Lironktf/Bluer/Arduino/MPU Connections Schematic Altium.JPG

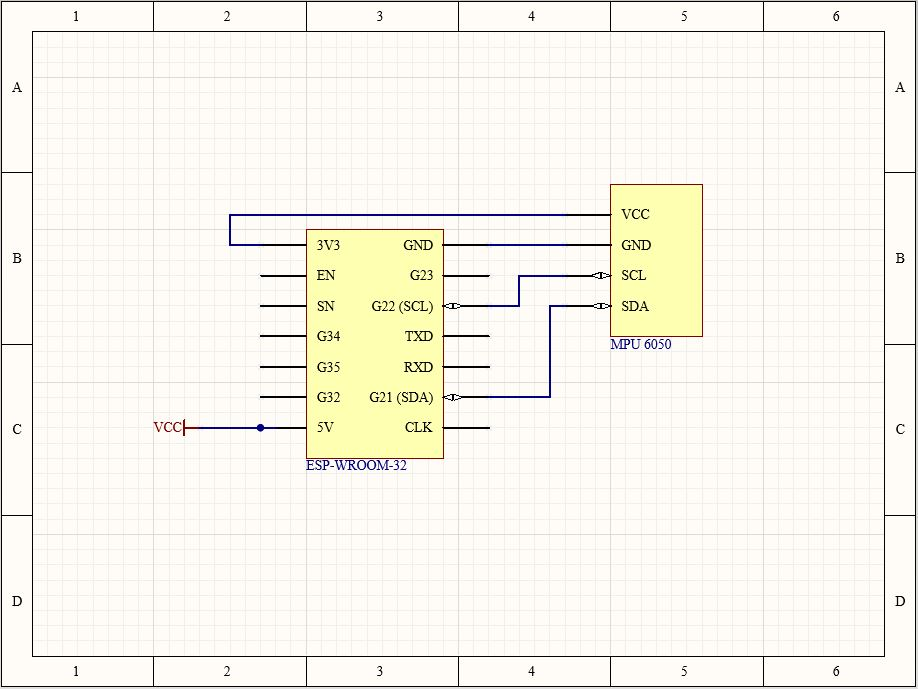
Arduino/MPU Connections Schematic Altium.JPG
