Lironktf/Bluer/onlineExmp/Ressources/ESP32_D1_Mini.stl

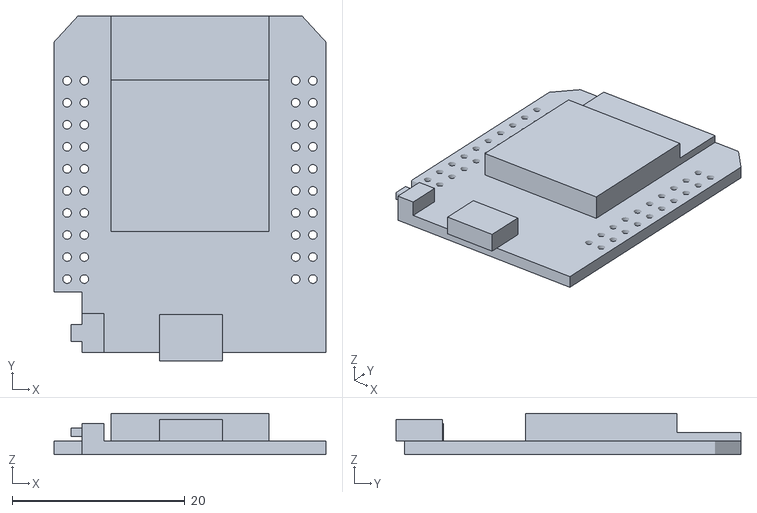
[picture p2: CAD file, 2026-01-26]
onlineExmp/Ressources/ESP32_D1_Mini.stl
31.5 x 40.0 x 4.80
