Lironktf/Bluer/(list of files, cad)

Other CAD files:
onlineExmp/Case/BLE-Scanner.scad
