Lironktf/Bluer/Arduino/tools/snapshot_recording.py

#!/usr/bin/env python3
"""Turns a recording CSV from /test/live into snapshot graphs of only the moments that matter.

On /test/live choose the pair, press Start recording, run your tests, then Download CSV
(a recording lasts a day at most, and the website deletes it 3 days after it ends). Then:

    pip3 install matplotlib
    python3 snapshot_recording.py sj-4_2026-11-04-14-03.csv
    python3 snapshot_recording.py day1.csv day2.csv --out my_test

Quiet stretches are skipped. Everything else becomes a PNG:
  washer  ~20 s around every burst of water over 20,000 (first fill, refills, a neighbour) or door
          drop over 700,000. Both sit below the node's thresholds on purpose, so near misses show.
          The last water-in before the washer stops running says when it stopped. Of a run of
          neighbour-only bursts (water while idle, no door), only the loudest is saved.
  dryer   a cycle is avg10 above the node's dryer-on threshold at that moment. Dips under it stay
          in the same cycle unless avg10 falls below 1.5 for over a minute. The first 2 min and the
          end are shown; the start snapshot gives the cycle's lowest avg10 and how often it dipped.
          Door jumps above the node's door threshold count only outside a cycle, since a running
          drum shakes the door too.
A dryer door bump and a washer door bump close together are tagged as possibly the same bump,
felt by both sensors of the pair. Graphs draw the thresholds the node had at that moment.
Times are in this computer's local time, to match your notes. Reads files only: it never
talks to a node or the website.
"""
import argparse
import bisect
import csv
import sys
from collections import namedtuple
from datetime import datetime, timedelta
from pathlib import Path

import matplotlib

matplotlib.use("Agg")  # files only, no window
import matplotlib.dates as mdates
import matplotlib.pyplot as plt

# Quiet cutoffs: a stretch below all four is never graphed.
WASHER_WATER = 20_000  # a washer's own running background and faint neighbours sit around 10,000-20,000
WASHER_DOOR = 700_000
# The dryer uses the node's own thresholds; these apply only to a CSV downloaded before they were included.
DRYER_ON = 2.2
DRYER_DOOR = 2.0

PERIOD = timedelta(seconds=5)  # each reading is the highest value of the 5 s ending at its time
MIN_SNAPSHOT = timedelta(seconds=20)
WASHER_PAD = timedelta(seconds=10)
WASHER_GAP = timedelta(seconds=15)  # bursts closer than this are one snapshot
START_BEFORE = timedelta(seconds=30)  # shown before a first fill
IDLE_SPAN = timedelta(minutes=1)  # a long neighbour stretch is shown as this much either side of its loudest reading
CYCLE_GAP = timedelta(seconds=60)  # any dip shorter than this stays inside the cycle
DIP_FLOOR = 1.5  # a longer dip stays inside it too, as long as avg10 never falls below this...
DIP_MAX = timedelta(minutes=10)  # ...for no longer than this
CYCLE_BEFORE = timedelta(seconds=30)
CYCLE_START = timedelta(minutes=2)
CYCLE_END = timedelta(minutes=2)
CYCLE_AFTER = timedelta(seconds=60)
DOOR_PAD = timedelta(seconds=20)
# A washer door bump this close to a dryer door bump may be the same one; the washer's readings
# reach the website up to ~15 s behind the dryer's.
MATCH_BEFORE = timedelta(seconds=20)
MATCH_AFTER = timedelta(seconds=35)
MATCH_NOTE = "could be activity from matching node"
SHORT_CYCLE = "cycle (possible just door opened triggering a cycle)"
IDLE_WATER = "water while idle (neighbour?)"
IDLE_RUN_GAP = timedelta(minutes=10)  # neighbour bursts closer than this count as one run

THRESHOLDS = ["dryer_on", "dryer_door", "first_fill", "refill", "refill_bands", "washer_door"]
BAND_NAMES = {1: "lower band", 2: "either band", 3: "upper band"}

Dryer = namedtuple("Dryer", "t avg10 door running empty")
Washer = namedtuple("Washer", "t w1 w2 drop running empty")
Window = namedtuple("Window", "start end label event note", defaults=("",))  # event: the first reading that caused it


def load(paths):
    dryer, washer, changes = {}, {}, {}
    for path in paths:
        with open(path, newline="", encoding="utf-8") as f:
            for row in csv.DictReader(f):
                t = datetime.fromisoformat(row["time"].replace("Z", "+00:00")).astimezone()
                # Thresholds are written on the first row and wherever they change.
                if all(row.get(k) for k in THRESHOLDS):
                    changes[t] = {k: float(row[k]) for k in THRESHOLDS}
                if row["machine"] == "dryer":
                    dryer[t] = Dryer(t, float(row["avg10"]), float(row["door_jump"]),
                                     int(row["running"]), int(row["empty"]))
                elif row["machine"] == "washer":
                    washer[t] = Washer(t, float(row["water1"]), float(row["water2"]), float(row["door_drop"]),
                                       int(row["running"]), int(row["empty"]))
    # Keyed by time, so files that overlap at their boundary don't double a reading.
    return [dryer[t] for t in sorted(dryer)], [washer[t] for t in sorted(washer)], sorted(changes.items())


class Thresholds:
    def __init__(self, changes):
        self.times = [t for t, _ in changes]
        self.values = [v for _, v in changes]

    def at(self, t):
        """The thresholds in force at t; {} for a CSV downloaded before they were included."""
        if not self.values:
            return {}
        return self.values[max(bisect.bisect_right(self.times, t) - 1, 0)]


def group(times, gap):
    """Consecutive times no more than gap apart, as [first, last] pairs."""
    groups = []
    for t in times:
        if groups and t - groups[-1][1] <= gap:
            groups[-1][1] = t
        else:
            groups.append([t, t])
    return groups


def widen(start, end):
    short = MIN_SNAPSHOT - (end - start)
    return (start - short / 2, end + short / 2) if short > timedelta(0) else (start, end)


def merge(windows):
    merged = []
    for w in sorted(windows, key=lambda w: w.start):
        if merged and w.start <= merged[-1].end:
            last = merged.pop()
            if not w.label or w.label in last.label.split(" + "):
                label = last.label
            else:
                label = f"{last.label} + {w.label}" if last.label else w.label
            note = "\n".join(n for n in (last.note, w.note) if n)
            merged.append(Window(last.start, max(last.end, w.end), label, min(last.event, w.event), note))
        else:
            merged.append(w)
    return merged


def rows_in(rows, w):
    return [r for r in rows if w.start <= r.t <= w.end + PERIOD]


def first_time(rows, hit, default):
    return next((r.t for r in rows if hit(r)), default)


def duration(td):
    seconds = max(int(td.total_seconds()), 0)
    return f"{seconds // 60} min {seconds % 60} s" if seconds >= 60 else f"{seconds} s"


def day(t):
    """4 Nov -> "4th Nov"."""
    suffix = "th" if 11 <= t.day % 100 <= 13 else {1: "st", 2: "nd", 3: "rd"}.get(t.day % 10, "th")
    return f"{t.day}{suffix} {t:%b}"


def washer_label(rows):
    labels = []
    if any(r.drop >= WASHER_DOOR for r in rows):
        labels.append("door")
    wet = [i for i, r in enumerate(rows) if max(r.w1, r.w2) >= WASHER_WATER]
    if wet:
        before = rows[wet[0] - 1].running if wet[0] > 0 else rows[0].running
        if not before and any(r.running for r in rows[wet[0]:]):
            labels.append("first fill")
        elif before:
            labels.append("water while running")
        else:
            labels.append("water while idle (neighbour?)")
    return " + ".join(labels)


def washer_windows(washer):
    # Water bursts are chained, but never across a start: a neighbour's water can sit above the
    # cutoff for half an hour and would otherwise glue itself to this washer's first fill.
    groups = []  # (rows, starts_cycle)
    for prev, r in zip([None] + washer[:-1], washer):
        if max(r.w1, r.w2) < WASHER_WATER:
            continue
        starts = prev is not None and not prev.running and r.running
        if groups and not starts and r.t - groups[-1][0][-1].t <= WASHER_GAP:
            groups[-1][0].append(r)
        else:
            groups.append(([r], starts))

    windows = []
    for rows, starts in groups:
        first, last = rows[0].t, rows[-1].t
        start, end = first - PERIOD - (START_BEFORE if starts else WASHER_PAD), last + WASHER_PAD
        if not any(r.running for r in rows) and last - first > 2 * IDLE_SPAN:
            first = max(rows, key=lambda r: max(r.w1, r.w2)).t
            start, end = first - IDLE_SPAN, first + IDLE_SPAN
        start, end = widen(start, end)
        windows.append(Window(start, end, "", first))

    doors = [r.t for r in washer if r.drop >= WASHER_DOOR]
    for first, last in group(doors, PERIOD * 2):
        start, end = widen(first - PERIOD - DOOR_PAD, last + DOOR_PAD)
        windows.append(Window(start, end, "", first))
    return [w._replace(label=washer_label(rows_in(washer, w))) for w in merge(windows)]


def refill_hit(r, th):
    if "refill" not in th:
        return max(r.w1, r.w2) >= WASHER_WATER
    bands = int(th["refill_bands"])
    return ((bands in (1, 2) and r.w1 > th["refill"])
            or (bands in (2, 3) and r.w2 > th["refill"]))


def end_notes(washer, windows, thresholds):
    """For each time the washer stopped running: a note on that cycle's last snapshot where the water
    was above the refill threshold the washer was following, i.e. the last water-in that reset its timer."""
    windows = list(windows)
    wet = [i for i, w in enumerate(windows) if "water" in w.label or "first fill" in w.label]
    previous_end = None
    for prev, r in zip(washer, washer[1:]):
        if not prev.running or r.running:
            continue
        in_cycle = [i for i in wet if windows[i].event < r.t and (previous_end is None or windows[i].event > previous_end)]
        previous_end = r.t
        for i in reversed(in_cycle):
            rows = rows_in(washer, windows[i])
            above = [k for k, row in enumerate(rows) if refill_hit(row, thresholds.at(row.t))]
            if not above:
                continue
            k = above[-1]
            th = thresholds.at(rows[k].t)
            # Without thresholds in the CSV, refill_hit falls back to the quiet cutoff.
            level = f"refill threshold ({th['refill']:,.0f})" if "refill" in th else f"quiet cutoff ({WASHER_WATER:,})"
            dipped = rows[k + 1].t if k + 1 < len(rows) else rows[k].t + PERIOD
            # Readings missing just before the end (Wi-Fi was down) mean it ended somewhere in the gap.
            ended = (f"between {prev.t:%H:%M:%S} and {r.t:%H:%M:%S} (readings missing)"
                     if r.t - prev.t > 3 * PERIOD else f"at {r.t:%H:%M:%S}")
            windows[i] = windows[i]._replace(note=(
                f"This is last water in, washer ended {ended} (running went false), "
                f"{duration(r.t - dipped)} after the water dropped below the {level} at {dipped:%H:%M:%S}"))
            break
    return windows


def keep_loudest_idle(washer, windows):
    """Of back-to-back neighbour-only snapshots, keeps only the loudest; door ones are always kept."""
    out, run = [], []

    def flush():
        if not run:
            return
        best = max(run, key=lambda w: max(max(r.w1, r.w2) for r in rows_in(washer, w)))
        if len(run) > 1:
            best = best._replace(note=f"Loudest of {len(run)} neighbour bursts from {run[0].start:%H:%M:%S} "
                                      f"to {run[-1].end:%H:%M:%S}; the others are not saved")
        out.append(best)
        run.clear()

    for w in windows:
        if run and (w.label != IDLE_WATER or w.start - run[-1].end > IDLE_RUN_GAP):
            flush()
        if w.label == IDLE_WATER:
            run.append(w)
        else:
            out.append(w)
    flush()
    return out


def dryer_on(thresholds, t):
    return thresholds.at(t).get("dryer_on", DRYER_ON)


def dryer_door(thresholds, t):
    return thresholds.at(t).get("dryer_door", DRYER_DOOR)


def dryer_cycles(dryer, thresholds):
    """[first, last] reading above the dryer-on threshold, joined across dips (see CYCLE_GAP, DIP_FLOOR)."""
    cycles, low = [], None  # low: the lowest avg10 since the last reading above the threshold
    for r in dryer:
        if r.avg10 > dryer_on(thresholds, r.t):
            gap = r.t - cycles[-1][1] if cycles else None
            if cycles and (gap <= CYCLE_GAP or ((low is None or low >= DIP_FLOOR) and gap <= DIP_MAX)):
                cycles[-1][1] = r.t
            else:
                cycles.append([r.t, r.t])
            low = None
        elif cycles:
            low = r.avg10 if low is None else min(low, r.avg10)
    return cycles


def cycle_note(dryer, thresholds, first, last):
    """How many times avg10 dipped under the threshold inside the cycle, and the note for its start."""
    inside = [r for r in dryer if first <= r.t <= last]
    above = [r.avg10 > dryer_on(thresholds, r.t) for r in inside]
    dips = sum(1 for a, b in zip(above, above[1:]) if a and not b)
    low = min(inside, key=lambda r: r.avg10)
    times = f"{dips} time{'' if dips == 1 else 's'}"
    note = (f"Lowest avg10 in this {duration(last - first + PERIOD)} cycle: {low.avg10:.3f} at {low.t:%H:%M:%S} "
            f"(dryer on {dryer_on(thresholds, low.t):g}); " + (f"dipped below it {times}" if dips else "never dipped below it"))
    return dips, times, note


def dryer_windows(dryer, thresholds):
    windows, busy = [], []
    for first, last in dryer_cycles(dryer, thresholds):
        start = first - PERIOD
        busy.append((start - CYCLE_BEFORE, last + CYCLE_AFTER))
        dips, times, note = cycle_note(dryer, thresholds, first, last)
        if last - start <= CYCLE_START + CYCLE_END:
            windows.append(Window(start - CYCLE_BEFORE, last + CYCLE_AFTER, SHORT_CYCLE, first, note))
            continue
        label = f"cycle start (dipped below threshold {times} during cycle)" if dips else "cycle start"
        # Loading usually opens the door right before the cycle starts; it is on this snapshot.
        if any(r.door > dryer_door(thresholds, r.t) for r in dryer if start - CYCLE_BEFORE <= r.t <= first):
            label += " + door"
        windows.append(Window(start - CYCLE_BEFORE, start + CYCLE_START, label, first, note))
        windows.append(Window(last - CYCLE_END, last + CYCLE_AFTER, "cycle end", last))

    # Inside a cycle or its snapshots the door jump is the drum shaking, or already on screen.
    doors = [r.t for r in dryer
             if r.door > dryer_door(thresholds, r.t) and not any(s <= r.t <= e for s, e in busy)]
    for first, last in group(doors, PERIOD * 2):
        start, end = widen(first - PERIOD - DOOR_PAD, last + DOOR_PAD)
        windows.append(Window(start, end, "door", first))
    return merge(windows)


def tag_matches(dryer, washer, dryer_ws, washer_ws, thresholds):
    """Tags dryer and washer door bumps close enough to be one bump felt by both sensors."""
    def bumps(ws, rows, hit):
        return {i: first_time(rows_in(rows, w), hit, w.event) for i, w in enumerate(ws) if "door" in w.label}

    d_bumps = bumps(dryer_ws, dryer, lambda r: r.door > dryer_door(thresholds, r.t))
    w_bumps = bumps(washer_ws, washer, lambda r: r.drop >= WASHER_DOOR)
    d_hits = {i for i, dt in d_bumps.items() if any(-MATCH_BEFORE <= wt - dt <= MATCH_AFTER for wt in w_bumps.values())}
    w_hits = {j for j, wt in w_bumps.items() if any(-MATCH_BEFORE <= wt - dt <= MATCH_AFTER for dt in d_bumps.values())}

    def tag(ws, hits):
        return [w._replace(label=f"{w.label} + {MATCH_NOTE}") if i in hits else w for i, w in enumerate(ws)]

    return tag(dryer_ws, d_hits), tag(washer_ws, w_hits)


def shade_running(ax, rows):
    for r in rows:
        if r.running:
            ax.axvspan(r.t - PERIOD, r.t, color="#fde68a", alpha=0.5, linewidth=0)


def threshold_line(ax, value, color, label):
    if value is not None:
        ax.axhline(value, color=color, linestyle="--", linewidth=1, label=label)


def finish(ax, ylabel, tz):
    ax.set_ylabel(ylabel)
    ax.grid(True, alpha=0.3)
    ax.legend(loc="upper left", fontsize="small")
    # Without tz, matplotlib labels the axis in UTC while the title is in local time.
    ax.xaxis.set_major_locator(mdates.AutoDateLocator(tz=tz))
    ax.xaxis.set_major_formatter(mdates.DateFormatter("%H:%M:%S", tz=tz))


def title(machine, w, th):
    lines = [f"{machine}: {w.label}   {day(w.start)} {w.start:%H:%M:%S} to {w.end:%H:%M:%S}   (yellow = running)"]
    if w.note:
        lines.append(w.note)
    if not th:
        lines.append("No thresholds in this CSV: download it again from /test/live to see them")
    return "\n".join(lines)


def plot_dryer(rows, w, th, path):
    fig, ax = plt.subplots(figsize=(10, 4))
    shade_running(ax, rows)
    times = [r.t for r in rows]
    ax.plot(times, [r.avg10 for r in rows], "o-", color="#2563eb", markersize=3, label="avg10 (max per 5 s)")
    ax.plot(times, [r.door for r in rows], "o-", color="#7c3aed", markersize=3, label="door jump (max per 5 s)")
    on, door = th.get("dryer_on"), th.get("dryer_door")
    threshold_line(ax, on, "#dc2626", f"dryer on {on:g}" if on is not None else "")
    threshold_line(ax, door, "#7c3aed", f"door change {door:g}" if door is not None else "")
    ax.set_xlim(w.start, w.end + PERIOD)
    finish(ax, "dryer", w.start.tzinfo)
    fig.suptitle(title("Dryer", w, th))
    fig.autofmt_xdate()
    fig.savefig(path, dpi=110, bbox_inches="tight")
    plt.close(fig)


def plot_washer(rows, w, th, path):
    fig, (water, door) = plt.subplots(2, 1, figsize=(10, 6), sharex=True)
    times = [r.t for r in rows]
    shade_running(water, rows)
    shade_running(door, rows)
    water.plot(times, [r.w1 for r in rows], "o-", color="#2563eb", markersize=3, label="water 7.9-9.8 kHz")
    water.plot(times, [r.w2 for r in rows], "o-", color="#0d9488", markersize=3, label="water 9.8-11.6 kHz")
    first_fill, refill, drop = th.get("first_fill"), th.get("refill"), th.get("washer_door")
    threshold_line(water, first_fill, "#dc2626", f"first fill {first_fill:,.0f}" if first_fill is not None else "")
    if refill is not None:
        bands = BAND_NAMES.get(int(th["refill_bands"]), "")
        threshold_line(water, refill, "#d97706", f"refill {refill:,.0f} ({bands})")
    door.plot(times, [r.drop for r in rows], "o-", color="#7c3aed", markersize=3, label="door drop (max per 5 s)")
    threshold_line(door, drop, "#dc2626", f"door drop (marks empty) {drop:,.0f}" if drop is not None else "")
    door.set_xlim(w.start, w.end + PERIOD)
    finish(water, "water bands", w.start.tzinfo)
    finish(door, "door band drop", w.start.tzinfo)
    fig.suptitle(title("Washer", w, th))
    fig.autofmt_xdate()
    fig.savefig(path, dpi=110, bbox_inches="tight")
    plt.close(fig)


def file_name(n, machine, w):
    prefix = "WASHER" if machine == "washer" and "first fill" in w.label else machine
    slug = w.label.replace(" + ", "_").replace(" ", "-")
    slug = "".join(c for c in slug if c.isalnum() or c in "-_")
    return f"{n:03d}_{prefix}_{slug}_{day(w.start).replace(' ', '-')}_{w.start:%H-%M-%S}.png"


def main():
    parser = argparse.ArgumentParser(description="Snapshot graphs from a /test/live recording CSV.")
    parser.add_argument("csv", nargs="+", help="recording CSV file(s)")
    parser.add_argument("--out", help="folder for the PNGs (default: next to the first CSV)")
    args = parser.parse_args()

    dryer, washer, changes = load(args.csv)
    if not dryer and not washer:
        sys.exit("No readings in those files.")
    thresholds = Thresholds(changes)
    if not changes:
        print("This CSV has no thresholds (downloaded before they were added); graphs will show none.")
    first = Path(args.csv[0])
    out = Path(args.out) if args.out else first.with_name(f"{first.stem}_snapshots")

    dryer_ws, washer_ws = dryer_windows(dryer, thresholds), washer_windows(washer)
    washer_ws = end_notes(washer, washer_ws, thresholds)
    dryer_ws, washer_ws = tag_matches(dryer, washer, dryer_ws, washer_ws, thresholds)
    washer_ws = keep_loudest_idle(washer, washer_ws)

    printed = []
    out.mkdir(parents=True, exist_ok=True)
    with open(out / "index.csv", "w", newline="", encoding="utf-8") as f:
        index = csv.writer(f)
        index.writerow(["file", "machine", "what", "day", "start", "end", "peak avg10", "peak dryer door jump",
                        "peak water 1", "peak water 2", "peak washer door drop", "note"])
        for machine, windows, rows_all in (("washer", washer_ws, washer), ("dryer", dryer_ws, dryer)):
            folder = out / machine
            folder.mkdir(exist_ok=True)
            # Numbered per machine, in time order.
            for n, w in enumerate(windows, 1):
                name = file_name(n, machine, w)
                rows = rows_in(rows_all, w)
                th = thresholds.at(w.event)
                if machine == "dryer":
                    plot_dryer(rows, w, th, folder / name)
                    peaks = [max(r.avg10 for r in rows), max(r.door for r in rows), "", "", ""]
                else:
                    plot_washer(rows, w, th, folder / name)
                    peaks = ["", "", max(r.w1 for r in rows), max(r.w2 for r in rows), max(r.drop for r in rows)]
                index.writerow([f"{machine}/{name}", machine, w.label, day(w.start), f"{w.start:%H:%M:%S}",
                                f"{w.end:%H:%M:%S}", *peaks, w.note])
                printed.append((w.start, f"{day(w.start)} {w.start:%H:%M:%S}  {machine:6}  {w.label}"))

    for _, line in sorted(printed):
        print(line)
    span = f"{min(r.t for r in dryer + washer):%H:%M} to {max(r.t for r in dryer + washer):%H:%M}"
    print(f"\n{len(dryer)} dryer and {len(washer)} washer readings, {span}.")
    print(f"{len(washer_ws)} washer and {len(dryer_ws)} dryer snapshots in {out} (list in index.csv).")


if __name__ == "__main__":
    main()
