Lironktf/Bluer/onlineExmp/BLE-Scanner/wifiHandler.cpp

/*
  BLE-Scanner

  (c) 2020 Christian.Lorenz@gromeck.de

  module to handle the WiFi stack


  This file is part of BLE-Scanner.

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
*/

#include "config.h"
#include "watchdog.h"
#include "wifiHandler.h"
#include "state.h"
#include "util.h"

WiFiClient _wifiClient;
static DNSServer *_dns_server = NULL;
static char _AP_SSID[64] = "";

/*
   setup wifi
*/
bool WifiSetup(void)
{
#if DBG_WIFI
  DbgMsg("WIFI: setting up wifi");
#endif

  LogMsg("WIFI: my MAC address is %s", WifiGetMacAddr().c_str());

  if (StateCheck(STATE_CONFIGURING)) {
    /*
       open an AccessPoint
    */
    uint8_t mac[MAC_ADDR_LEN];
    WiFi.macAddress(mac);
    strcpy(_AP_SSID, (String(WIFI_AP_SSID_PREFIX) + String(AddressToString((byte *) mac + sizeof(mac) - WIFI_AP_SSID_USE_LAST_MAC_DIGITS, WIFI_AP_SSID_USE_LAST_MAC_DIGITS, false, ':'))).c_str());

    LogMsg("WIFI: opening access point with SSID %s ...", _AP_SSID);
    WiFi.mode(WIFI_AP);
    WiFi.softAP(_AP_SSID);
    delay(1000);
    IPAddress Ip(192, 168, 1, 1);
    IPAddress NMask(255, 255, 255, 0);
    WiFi.softAPConfig(Ip, Ip, NMask);

    LogMsg("WIFI: local IP address %s", IPAddressToString(WiFi.softAPIP()).c_str());

    /*
       configure the DNS so that every requests will go to our device
    */
    _dns_server = new DNSServer();
    _dns_server->setErrorReplyCode(DNSReplyCode::NoError);
    _dns_server->start(DNS_PORT, "*", WiFi.softAPIP());
    return false;
  }
  else {
    /*
      connect to the configured Wifi network
    */
#if DBG_WIFI
    DbgMsg("WIFI: SSID=%s  PSK=%s", _config.wifi.ssid, _config.wifi.psk);
#endif

    WiFi.mode(WIFI_STA);
    WiFi.begin(_config.wifi.ssid, _config.wifi.psk);

    LogMsg("WIFI: waiting to connect to %s ...", _config.wifi.ssid);
  }
  return WifiUpdate();
}

/*
    do Wifi updates
*/
bool WifiUpdate(void)
{
  if (StateCheck(STATE_CONFIGURING)) {
    /*
       we are in configuration mode

       as we are the DNS, we have to answer the requests
    */
    if (_dns_server)
      _dns_server->processNextRequest();
  }
  else {
    /*
       normal operation mode
    */
    if (WiFi.status() != WL_CONNECTED) {
      /*
         wait to connect
      */
      int timeout = WIFI_CONNECT_TIMEOUT;

#if DBG_WIFI
      DbgMsg("WIFI: status is not connected ... waiting for %d seconds for connection",WIFI_CONNECT_TIMEOUT);
#endif
      while (WiFi.status() != WL_CONNECTED) {
        delay(1000);
        WatchdogUpdate();
        if (--timeout <= 0) {
          LogMsg("WIFI: giving up after %d seconds", WIFI_CONNECT_TIMEOUT);
          return false;
        }
      }

      /*
         up an running
      */
      IPAddress ip = WiFi.localIP();
      LogMsg("WIFI: connected to %s with local IP address %s", _config.wifi.ssid, IPAddressToString(ip).c_str());

      return true;
    }
  }
  return true;
}

/*
   return the SSID
*/
String WifiGetSSID(void)
{
#if DBG_WIFI
  DbgMsg("WIFI: entering WifiGetSSID()");
#endif

  return StateCheck(STATE_CONFIGURING) ? _AP_SSID : WiFi.SSID();
}

/*
   return the SSID
*/
int WifiGetChannel(void)
{
#if DBG_WIFI
  DbgMsg("WIFI: entering WifiGetChannel()");
#endif

  return WiFi.channel();
}

/*
   return the SSID
*/
int WifiGetRSSI(void)
{
#if DBG_WIFI
  DbgMsg("WIFI: entering WifiGetRSSI()");
#endif

  return WiFi.RSSI();
}


/*
   return the SSID
*/
String WifiGetIpAddr(void)
{
#if DBG_WIFI
  DbgMsg("WIFI: entering WifiGetIpAddr()");
#endif

  return IPAddressToString(StateCheck(STATE_CONFIGURING) ? WiFi.softAPIP() : WiFi.localIP());
}

/*
   return the Wifi MAC address
*/
String WifiGetMacAddr(void)
{
#if DBG_WIFI
  DbgMsg("WIFI: entering WifiGetMacAddr()");
#endif

  uint8_t mac[MAC_ADDR_LEN];

  WiFi.macAddress(mac);
  return String(AddressToString((byte *) mac, sizeof(mac), false, ':'));
}


WiFiClient *WifiGetClient(void)
{
#if DBG_WIFI
  DbgMsg("WIFI: entering WifiGetClient()");
#endif

  return &_wifiClient;
}/**/
