Lironktf/Bluer/onlineExmp/BLE-Scanner/httpApi.cpp

// DEPRECATED - This file is no longer used
// MQTT is used instead (see mqtt.cpp)
// This stub exists only to satisfy Arduino IDE caching

#include "config.h"

void HttpApiSetup(void) {}
void HttpApiUpdate(void) {}
bool HttpApiPostMachineStatus(const char* machineId, bool running, bool empty) { return false; }
