Lironktf/Bluer/(commit log)

2025-12-21 oliver changes
    [Sheet1_Project.SchDoc]
2025-12-21 Modify Wire.begin parameters and update print_accels
2025-12-22 making the changes for the confirmation of the broken state
    [1MPUaccelerometercode.ino]
2025-12-22 adding api endpoint for esp32
2026-01-10 implementing api to communicate esp32 with dashboard
2026-01-10 fix: consolidate API endpoints and remove mock data
    [1MPUaccelerometercode.ino]
2026-01-21 try to fix router2
    [router2.ino]
2026-01-22 cant see ble devices
2026-01-26 Add onlineExmp files to repository
    [BLE-Scanner.scad, ESP32_D1_Mini.stl]
2026-07-22 Change sample rate and modify intake thresholds
    Updated sample rate and adjusted thresholds for water intake detection.
2026-07-26 Change BLE name and refine timer constants
    Updated BLE name and adjusted timer values for accuracy.
2026-08-30 Update washer BLE name and timer constants
2026-09-25 Rename Project Schematic Altium.JPG to MPU Connections Schematic Altium.JPG
